albakri3008092/kik-shooting-target/(commit log)

2026-04-19 CI: pin ESP32 core to 2.0.17 (callback signature matches our sketches)
2026-04-19 Support ESP32 Arduino core 3.x (recv-callback signature shim)
    The ESP-NOW recv callback signature changed between core 2.x and 3.x:
    2.x: void cb(const uint8_t* mac, const uint8_t* data, int len)
    3.x: void cb(const esp_now_recv_info_t* info, const uint8_t* data, int len)
    Adds an #if ESP_ARDUINO_VERSION_MAJOR >= 3 shim to every ESP-NOW
    recv callback in the repo so the same sketch compiles on both cores.
    CI now runs the firmware compile matrix on both 2.0.17 and 3.1.3 to
    keep both paths green.
2026-04-19 Add LEDC API shim for ESP32 core 3.x
    Core 3.x deprecated the channel-based LEDC API:
    2.x: ledcSetup(ch,f,res) + ledcAttachPin(pin,ch) ; ledcWriteTone(ch,f)
    3.x: ledcAttach(pin,f,res) ; ledcWriteTone(pin,f)
    Introduces KIK_BUZZ_SETUP / KIK_BUZZ_TONE macros so the same sketch
    compiles on both cores.
2026-04-19 CI: split matrix so demo sketches test on core 2.x + 3.x, v2 firmware stays on 2.0.17
    ESPAsyncWebServer (me-no-dev fork) still calls removed mbedtls APIs on
    core 3.x. Until we migrate to the maintained ESP32Async fork, keep
    full v2 firmware compile pinned to 2.0.17.
    The DEMO sketches only use built-in WebServer.h and now compile cleanly
    on both 2.0.17 and 3.1.3 thanks to the ESP-NOW and LEDC shims.
2026-04-22 demo: show which sensor detected each bullet on the tablet
    Adds presentation-ready visibility on the tablet dashboard:
    - central_demo.ino: keep a 16-slot ring buffer of recent hits and
    expose it via /status as "recent":[{t,s,z,sc,ago},...] (newest
    first); reset clears it.
    - Embedded dashboard:
    * New 'SENSOR TERAKHIR' badge per target card (coloured S1..S4).
    * Per-sensor counter boxes now labelled 'S1 Zon 10' ... 'S4 Zon 4'
    and pulse on hit.
    * New 'Tembakan Terkini' feed at the bottom listing the last 16
    hits across all 3 targets as 'Tn Sn Zone score ago'.
    * Dot placement on the bullseye follows lastSensor, not lastZone.
    - simulator.js: generates and serves th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
    [central_demo.ino]
2026-04-22 demo: add PANDUAN_LENGKAP_BM.md — step-by-step BM guide for presentation
    Tambah panduan lengkap Bahasa Malaysia langkah demi langkah untuk
    bentang prototaip. Semua kod siap cut-and-paste dalam markdown:
    - BOM lengkap (12 piezo = 4 per sasaran x 3 sasaran)
    - Install Arduino IDE + ESP32 board manager
    - Pendawaian per sasaran (ASCII diagram + jadual GPIO)
    - Langkah 1: get_mac.ino (inline, 20 baris)
    - Langkah 2: flash ESP32 pusat (rujuk central_demo.ino yang wujud)
    - Langkah 3: flash ESP32 sasaran x 3 (target_demo.ino inline, 115 baris)
    - Langkah 4: sambung tablet ke Target_System / 12345678 / 192.168.4.1
    - Langkah 5: uji tembakan dengan cara ketuk
    - Check-list bentang + skrip 3 minit + troub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
2026-04-22 demo: panduan — amaran struktur folder Arduino + kosongkan editor sebelum paste
    User laporan compile error 'redefinition of void setup()' sebab:
    1. Folder disimpan sebagai 'get_mac.ino/' → fail jadi 'get_mac.ino.ino'.
    2. Paste kod baru tanpa kosongkan editor → 2 void setup() dalam fail.
    Tambah dalam panduan:
    - Seksyen ⚠️ PENTING di bawah Perisian: rajah folder BETUL vs SALAH.
    - Arahan File → New Sketch → Save As (tanpa .ino) → Ctrl+A Delete → Ctrl+V.
    - Langkah 1.1 (get_mac) dan 3.1 (target_demo) dikemas kini dengan aliran
    cipta folder + kosongkan editor sebelum paste.
2026-04-22 demo: fix central MAC print (00:00:00:00) + lock channel 1 for ESP-NOW
    User laporan 'MAC: 00:00:00:00:00:00' dari Serial Monitor central_demo.
    Sebab: WiFi.mode(WIFI_AP) tak aktifkan interface STA, jadi
    WiFi.macAddress() kembali alamat semua sifar. Fix:
    - central_demo.ino: cetak WiFi.softAPmacAddress() (bukan WiFi.macAddress()).
    Ini adalah MAC yang perlu dimasukkan ke RECEIVER_MAC[] dalam target_demo
    untuk ESP-NOW. Tambah anotasi dalam output print supaya jelas.
    - Kunci channel ke 1 pada kedua-dua belah untuk kestabilan ESP-NOW:
    * central: WiFi.softAP(ssid, pwd, 1)
    * target: esp_wifi_set_channel(1, WIFI_SECOND_CHAN_NONE)
    peer.channel = 1
    - Kemas kini PANDUAN_LENGKAP_B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
    [central_demo.ino, target_demo.ino]
2026-04-22 demo: target baseline-tracking for piezo without 1M pull-down resistors
    User nak demo esok tanpa perintang luaran. Ubah target_demo.ino supaya:
    - GPIO 32, 33: aktifkan INPUT_PULLDOWN dalaman (ESP32 support pull-down
    internal pada pin ini).
    - GPIO 34, 35: input-only, tiada pull dalaman -> guna baseline tracking
    dalam perisian. Exponential moving average (shift 5 = time-constant
    32 sampel) untuk jejak drift/nilai terapung, kemudian trigger hanya
    bila sample melebihi baseline + TRIG_DELTA (2000 count).
    - DEBOUNCE_MS dinaikkan 150 -> 250 untuk tolak 'ringing' hit.
    - Baseline hanya dikemaskini bila TIADA trigger, supaya peak hit tidak
    diserap masuk baseline.
    Semua pin kekal 32..35 (AD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
    [target_demo.ino]
2026-04-22 demo: drop WIFI_PROTOCOL_LR so AP visible to phones/tablets
    User laporan 'Target_System' WiFi tak muncul dalam senarai scan pada
    semua peranti, walau pun Serial Monitor pusat tunjuk softAP running.
    Punca: saya set WIFI_PROTOCOL_LR pada central's AP interface. LR ialah
    mod proprietary ESP-NOW/ESP32 — AP beacons dihantar dalam format LR
    yang 802.11 clients biasa (telefon/tablet) tidak kesan.
    Fix: buang WIFI_PROTOCOL_LR dari kedua-dua central (AP) dan target
    (STA). Guna B/G/N sahaja. ESP-NOW masih berfungsi di atas 11N.
    Jangkauan ~50-100m masih mencukupi untuk demo dalam dewan.
    Kemas kini inline code block dalam PANDUAN_LENGKAP_BM.md.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
    [central_demo.ino, target_demo.ino]
2026-04-22 demo: per-sensor health monitoring (OK / NOISY / ROSAK / ?)
    User meminta setiap sensor hantar data dan dipaparkan supaya juri
    nampak sensor elok atau rosak.
    Target side (target_demo.ino):
    - Tambah HealthPacket (type 3): hantar baseline[4] + peak[4] setiap 2s.
    - Jejak 'peakWindow' dalam loop \u2014 amplitud tertinggi antara health
    packets, reset selepas setiap penghantaran.
    Central side (central_demo.ino):
    - Parse HealthPacket (type 3) dalam onEspNow dengan dispatch ikut type
    byte (elak misread antara HitPacket vs HealthPacket saiz berbeza).
    - TargetState simpan baseline[4], peak[4], lastHealthMs per sasaran.
    - /status JSON kini termasuk 'sensors':[{bl,pk,h}] per target dengan
    klasifi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
    [central_demo.ino, target_demo.ino]
2026-04-22 demo: lower piezo trigger delta 2000->800 and clamp baseline at 1500
    User test: target 1/3 aktif di dashboard (ESP-NOW OK) tetapi ketukan
    piezo tak detect sebagai hit.
    Punca:
    - TRIG_DELTA=2000 terlalu tinggi untuk piezo tanpa pull-down resistor.
    - Baseline EMA pada GPIO 34/35 (floating, no internal pull-down) boleh
    drift ke nilai tinggi. Jika baseline mencapai >2095, trig threshold
    = baseline+2000 > 4095 (ADC max), jadi tiada sampel boleh lulus
    threshold dan hit tidak akan trigger.
    Fix:
    - TRIG_DELTA: 2000 -> 800 (lebih sensitif ke ketukan lembut).
    - Kapit baseline kepada BASELINE_MAX=1500 sebelum tambah TRIG_DELTA.
    Trig akhir sentiasa <= 2300, sentiasa boleh dilalui oleh spike piez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
    [target_demo.ino]
2026-04-22 demo: rising-edge detection to reject floating-pin false positives
    User laporan: tanpa ketuk, kaunter hit berjalan sendiri. Punca: pin
    GPIO 34/35 (input-only, tanpa pull-down dalaman / perintang luaran)
    terapung; ADC baca nilai rawak yang kadangkala lulus threshold.
    Fix: tambah syarat KEDUA \u2014 rising edge.
    Hit sebenar = sampel sekarang > threshold mutlak DAN sampel - prev
    sampel > FAST_RISE (600 counts).
    Piezo strike sebenar menghasilkan spike millisecond-scale yang MUDAH
    lulus rising-edge 600 (biasanya 1500-2500 jump dalam satu step). Pin
    floating yang drift perlahan-perlahan TIDAK akan lulus walaupun duduk
    pada nilai tinggi.
    Juga: baseline EMA kini hanya adapt bila sampel < trig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
    [target_demo.ino]
2026-05-01 prototype_v2: Stage 1-4 (double-tap + triangulation + canvas viz)
    Implementasi versi prototype yang dibina di atas pelajaran dari demo,
    untuk kegunaan ujinilai sebenar (latihan menembak / penilaian double-tap).
    Penambahbaikan dari demo v1:
    1. Hit-window state machine (target_v2): bila satu piezo trigger,
    capture peak SEMUA 4 sensor untuk window 30ms. Membolehkan central
    buat amplitude triangulation.
    2. Lower debounce (60ms) + 30ms hit window = boleh detect double-tap
    dengan split 0.10s antara peluru.
    3. New protocol HitPacketV2: rich event dengan peak[4] + timestamp +
    trigger sensor. Kekal HeartbeatPacket (type 2) dan HealthPacket
    (type 3) backward compat secara format.
    4. Ce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
2026-05-01 prototype_v2: Stage 5+6 (calibration mode + SPIFFS session log)
    Stage 5 — per-sensor gain calibration:
    * Each target stores 4 reference peak values in NVS Preferences.
    * Triangulation normalizes raw peaks (peak[i] / refPeak[i]) before the
    weighted-centroid is computed, so piezos with different sensitivity
    no longer bias the result toward the loudest sensor.
    * Calibration UX is a 4-step state machine: tap S1, S2, S3, S4 in turn.
    Hits during calibration do NOT advance the target's score — they are
    training samples only. The buzzer still chirps so the user has
    feedback per tap.
    * New endpoints: POST /cal/start?target=N, POST /cal/cancel,
    POST /cal/clear?target=N.
    * /status JSON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
    [central_v2.ino]
2026-05-01 prototype_v2: simpler 5-ring scoring (5/4/3/2/1 marks)
    User-requested: replace the ISSF 10-ring zone table with a flat 5-zone
    concentric layout — centre 5 marks, outward to 1 mark at the edge, miss
    beyond.
    Firmware:
    * RING_R / RING_SCORE shrunk to 5 entries (0.20, 0.40, 0.60, 0.80, 1.30
    normalized radii; 5/4/3/2/1 marks).
    * scoreZone() walks NUM_RINGS instead of hard-coded 11.
    * TargetState.lastZone, RecentHit.zone re-documented (0=centre, 4=edge,
    5=miss).
    * lastZoneLabel JSON now derives from RING_SCORE[zone] directly.
    Dashboard:
    * RING_R / RING_PTS arrays mirror the firmware constants.
    * drawTarget() paints 5 alternating-color rings + zone-number labels
    (5,4,3,2,1) along the +X a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
    [central_v2.ino]
2026-05-01 review: address Devin Review feedback (RING_R parity, non-blocking buzzer, feed cache, zone-0 ambiguity)
    Four fixes from PR #3 review:
    1. (Critical) RING_R outermost mismatch
    The JS dashboard had RING_R[4]=1.00 while the C++ scoreZone() classified
    any hit with r <= 1.30 as 1-mark. So a hit at r=1.15 scored on the
    server but appeared visually outside all drawn rings. Sync JS to 1.30.
    2. Non-blocking buzzer in v2 loop
    Replaced 'delay(20)' inside loop() with the same buzzOff timestamp
    pattern the demo central uses. Under 60ms debounce, hits can arrive
    every ~90ms; the 20ms delay was starving server.handleClient() and
    the SPIFFS log queue drain.
    3. demo feed cache key chu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
    [central_demo.ino, central_v2.ino]
2026-05-02 prototype_v2: scale to 15 targets
    - NUM_TARGETS 3 -> 15 in central_v2.ino
    - Bump RECENT_N (24 -> 48) and LOG_QUEUE_LEN (64 -> 128) so the feed and
    SPIFFS log queue absorb hits across 15 lanes without dropping
    - Bump status JSON String reserve (2048 -> 12288 B) to fit ~15x per-target
    blocks plus the larger recent buffer
    - Dashboard JS const N = 3 -> 15 to build cards for all lanes
    - Tighten grid card minmax (330px -> 260px) so 15 cards stay readable on
    a typical tablet (3-4 cards/row instead of 2)
    - Document multi-lane setup + ESP-NOW peer note in prototype_v2/README.md
    - Clarify target_v2.ino TARGET_ID range (1..15)
    [central_v2.ino, target_v2.ino]
2026-05-02 review: defer NVS calibration save to main loop (avoid WiFi-task race)
    Devin Review flagged the NVS Preferences object (gPrefs) being touched
    from two tasks: the WiFi task (saveCalibrationFor() called from the
    onEspNow callback after the 4th calibration tap) and the Arduino main
    loop (clearCalibrationFor() called from handleCalClear()). The shared
    Preferences instance's internal NVS handle is not safe to begin()/end()
    concurrently, and a flash write in the receive callback also blocks
    heartbeat/health/hit packets for tens of ms while the cell is rewritten.
    Fix: when calibration completes in onEspNow, copy the 4 captured peaks
    to gCalCommitRef[] and set gCalCommitPending=true. The main loop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
    [central_v2.ino]
2026-05-02 prototype_v2: add step-by-step setup guide (BM) for 15 targets
2026-05-02 central_v2: cache-busting on /status + fix dead-code split fallback
    Devin Review fixes:
    1. /status caching (BUG_..._0001, comment 3176509994):
    - Server: add Cache-Control: no-store header in handleStatus()
    - Client: fetch('/status', {cache:'no-store'})
    Mobile browsers (tablets/phones \u2014 the primary deployment target)
    can aggressively cache responses without an explicit directive,
    causing the 200ms-polling dashboard to display stale data.
    2. Feed split-time '\u2014' fallback unreachable (BUG_..._0002, comment 3176510053):
    - r.splitMs is uint16 \u2014 always >= 0 in JSON, so the '\u2014'
    branch was dead code and the very first hit on each target
    (splitMs=0, no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
    [central_v2.ino]
2026-05-02 central_v2: hit-based dead-sensor detection (DEAD/MATI state)
    A broken or disconnected piezo wire produces baseline ~0 (the internal
    pull-down or external 1 M\u03a9 holds the line at GND), which is
    electrically indistinguishable from a working but idle sensor. The
    existing baseline-only health classifier therefore reported wire
    breaks as 'OK' \u2014 confirmed by the user during hardware bring-up.
    Add a hit-history-based check: during every accepted shot, a working
    piezo always picks up SOME mechanical vibration (even cross-target
    propagation typically lifts an idle sensor by 50\u2013500 ADC counts).
    A broken wire stays flat. Track per-sensor 'silent streak' and, after
    3 consecutive silent h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
    [central_v2.ino]
2026-05-02 SETUP guide: document MATI (dead-sensor) state + test procedure
2026-05-03 esp-now: shim onSent() callback for ESP32 core 3.3+
    ESP32 Arduino core 3.3 changed esp_now_register_send_cb() signature
    from 'const uint8_t* mac' to 'const wifi_tx_info_t* info'. Users on
    the latest IDE Boards Manager (3.3.8) hit a hard compile error:
    error: invalid conversion from
    'void (*)(const uint8_t*, esp_now_send_status_t)'
    to
    'esp_now_send_cb_t' {aka
    'void (*)(const wifi_tx_info_t*, esp_now_send_status_t)'}
    Switch the callback prototype at compile time using
    ESP_ARDUINO_VERSION_MAJOR/MINOR so the same source builds on:
    - 2.x (legacy)
    - 3.0..3.2 (existing)
    - 3.3+ (new signature)
    Apply to both target_v2.ino and demo/target_demo.ino. Add 3.3.0 to
    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
    [target_demo.ino, target_v2.ino]
2026-05-03 target: disable brownout detector to survive low-current USB supplies
    User hit an SW_RESET loop on the target board with the log:
    E BOD: Brownout detector was triggered
    Even after switching from the power bank to the laptop USB port. Cheap/
    short USB cables and the typical laptop USB-2 5V rail just cannot
    supply the 250\u2013500 mA spike ESP32 draws when WiFi transmits, and the
    on-chip BOD aggressively resets at the dip. This makes ESP-NOW look
    broken (target never sends a heartbeat the central can receive) when
    the real fault is at the power rail.
    Disable the BOD via RTC_CNTL_BROWN_OUT_REG=0 in setup(). The proper
    fix is a beefier supply + bulk capacitor, but with BOD off the user
    ca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
    [target_demo.ino, target_v2.ino]
2026-05-03 ci: retry — previous run hit 502 on mklittlefs download
2026-05-03 central: add idle baseline-zero MATI detection for hardware-only test
    The hit-based dead-sensor check (commit 8b820b3) only fires when at
    least one piezo on the target crosses the trigger threshold, because
    that is what triggers HitPacketV2 emission. In a freshly-built proto-
    type where only one piezo is wired (or only one functional), cutting
    that wire means NO sensor crosses threshold and the central never
    sees a hit at all \u2014 so deadStreak never increments and the wire-cut
    sensor stays labelled 'ok' indefinitely.
    Add a second, complementary detection path that runs purely from the
    HealthPacket stream (sent every ~2 s regardless of activity):
    * On each Health, if baseline[i] <= ZER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
2026-05-03 central: hoist health thresholds above onEspNow
    Forward-declare ZERO_BASELINE_THRESH near TargetState so onEspNow's
    HealthPacket handler can reference it. The compile failure on core
    2.0.17 was a pure ordering issue:
    error: 'ZERO_BASELINE_THRESH' was not declared in this scope
    Same constants, just moved earlier in the file.
    [central_v2.ino]
2026-05-03 health: 5 s heartbeat per sensor, MATI after 1 silent window
    Switch the Health-packet cadence from 2 Hz to once every 5 s and tighten
    the idle MATI rule:
    * target_v2.ino: HEALTH_INTERVAL_MS 2000 \u2192 5000.
    * central_v2.ino: ZERO_BASELINE_STREAK_N 5 \u2192 1 (one silent 5-s window
    is enough to flag MATI \u2014 the user explicitly wants a 5-second
    detection window).
    * central_v2.ino: also require peak[i] <= ZERO_BASELINE_THRESH (not
    just baseline). A connected piezo always shoves *some* ADC variance
    into the in-window peak even when idle, so peak == 0 is what
    actually distinguishes a cut wire from a quiet but live sensor.
    * central_v2.ino: bump haveHealth window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
    [central_v2.ino, target_v2.ino]
2026-05-03 target: revert brownout-detector disable; restore default-on BOD
    The BOD-disable workaround (commit 410c52f) traded one failure mode
    for a worse one: with BOD on, a marginal 5V rail produces a clean
    'E BOD: Brownout detector was triggered' reset that points the user
    straight at the hardware. With BOD off, the chip keeps running with
    partially-corrupted RAM during the dip and ends up in a panic-handler
    loop with garbage program counters and a |<-CORRUPTED backtrace,
    which is much harder to interpret as 'fix your power supply'.
    This change applies to both the prototype v2 target and the demo
    target so behaviour matches across firmware. Users who hit the BOD
    trigger should switch to a USB char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
    [target_demo.ino, target_v2.ino]
2026-05-03 target: disable BOD again on bench-supply targets
    User's bench rig is a single laptop USB-2 port with no AC charger
    available. With BOD enabled, every reflash drops the board into an
    'E BOD: Brownout detector was triggered' loop the moment WiFi tries
    to transmit \u2014 setup() never finishes, no Health, no hits, nothing.
    We previously re-enabled BOD because BOD-off had produced a single
    'Panic handler entered multiple times' incident with a corrupted
    backtrace, but on the same supply BOD-on is *guaranteed* to fail
    while BOD-off has been observed booting cleanly to 'Target v2 #1
    ready' on the same hardware. Disabling BOD is therefore the lesser
    evil for this deployment.
    Per-firmware comment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
    [target_demo.ino, target_v2.ino]
2026-05-03 central: raise idle MATI threshold 10 \u2192 50 ADC counts
    User reported S2/S3/S4 cycling correctly between MATI (idle) and OK
    (when tapped) but S1 staying 'OK' even after the user physically cut
    S1's signal wire. The cut wire on GPIO 32 sits at the internal
    pull-down floor in steady state, but it also acts as a short
    high-impedance antenna and picks up enough EMI / ADC-channel
    crosstalk that the EMA baseline lands somewhere in the 10-30 ADC
    counts range \u2014 just barely above the previous threshold of 10, so
    sensorHealthLabel returned 'ok'.
    50 counts (\u2248 1.2 % of 12-bit full-scale) is comfortably above the
    open-wire noise floor and comfortably below where a real piezo idles:
    * Con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
    [central_v2.ino]
2026-05-03 central: echo every received Health packet to Serial
    Mobile Chrome (the user's tablet browser) silently drops the
    title='baseline=...' tooltip on the per-sensor pills, so the values
    that the central is using to classify a sensor as MATI vs OK are
    currently invisible from the dashboard. Adding a single
    Serial.printf line per Health rx exposes the exact baseline / peak
    the central received plus the running silent-window streak, which
    makes threshold tuning (ZERO_BASELINE_THRESH) a 30-second job:
    hook the central to a laptop, open Serial Monitor, watch the
    numbers from a sensor with a known-cut wire as the board is moved.
    The print runs once per target every HEALTH_INTERVAL_MS (5 s) so
    it does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
2026-05-03 central: differential silent-sensor detection (only flag MATI when others active)
    The previous absolute-silence rule (peak <= ZERO_BASELINE_THRESH for N
    windows) couldn't distinguish a cut wire from a connected piezo at
    rest \u2014 both read ADC 0 on a properly pulled-down pin, so it would
    either false-flag every idle sensor as MATI (threshold too loose) or
    miss real cut wires that picked up enough EMI to cross the floor
    (threshold too tight). User confirmed both failure modes on the bench:
    all 4 sensors idle reported bl=0/pk=0 with streak rising, and a single
    board nudge on a cut S1 wire was enough to reset the streak.
    New logic per Health window: for each sensor, only bump its
    'silent-in-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
    [central_v2.ino]
2026-05-03 central: drop SILENT_IN_ACTIVE_STREAK_N from 2 to 1 for snappier demo
    User-tuned for the prototype demo: a single 5 s Health window with
    this sensor silent while another sensor on the same target saw
    activity (peak >= SILENT_ACTIVITY_THRESH) is now enough to surface
    the sensor as MATI. Previous value of 2 added an extra ~5 s of
    detection latency that made the cut-wire demo feel sluggish.
    The differential nature of the check (we still require an OTHER
    sensor on the same target to have crossed the activity threshold in
    the same window) keeps the lower streak from false-flagging idle
    targets \u2014 if every sensor on the target is quiet, every streak just
    holds steady at zero.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
    [central_v2.ino]
2026-05-03 prototype_v2: active per-sensor self-test for autonomous MATI on S1/S2
    Adds an active capacitance probe to target_v2.ino that runs once per
    Health interval (5 s) on every pin that supports OUTPUT drive. The
    probe briefly drives the pin HIGH, switches to high-Z INPUT, and
    samples the ADC after 200 us. With the production 1 MOhm pull-down +
    a connected piezo (~1 nF body capacitance) the pin sits well above
    1.5 V at that point; a cut wire (only parasitic ~10 pF) has fully
    discharged to 0 V. The verdict is reported in a new HealthPacket
    field connected[4], with the raw ADC reading mirrored in
    selfTestRaw[4] for diagnostic purposes.
    central_v2.ino tracks notConnectedStreak[4] per target. After
    N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
2026-05-03 target: snapshot peakWindow before runSelfTest() to prevent S1/S2 false MATI
    runSelfTest() zeroes peakWindow[i] on every probed pin (S1/S2) so the
    3.3 V drive pulse used by the active capacitance probe can't show up
    as a fake rising-edge hit on the next IDLE scan iteration. The
    zeroing is correct in isolation, but sendHealth() was reading
    peakWindow[] into h.peak[i] AFTER calling runSelfTest(), which meant
    S1/S2 always reported peak = 0 on every Health packet regardless of
    real piezo activity in the 5-second window.
    On the central, the differential silent-in-active-window check then
    saw S1/S2 as 'always silent' while S3/S4 (which still report real
    peaks because their input-only pins skip th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
    [target_v2.ino]
2026-05-03 target: also snapshot baseline before runSelfTest() (same bug class as peakWindow)
    Companion fix to 60555ab. runSelfTest() doesn't only zero peakWindow[i]
    on every probed pin — it also re-seeds baseline[i] = BASELINE_SEED
    (150) so the EMA can't latch onto the residual ADC reading right
    after the 3.3 V drive pulse. sendHealth() was reading baseline[]
    AFTER calling runSelfTest(), so S1/S2 would have shipped baseline
    hard-pinned at 150 in every Health beat regardless of real
    conditions.
    Two central-side health classifications were silently broken:
    * sensorHealthLabel() checks 'baselineV >= 3000 -> broken' and
    'baselineV >= 1000 -> noisy' \u2014 neither would ever fire on S1/S2
    beca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
    [target_v2.ino]
